Rowan-Rocketry/Control-Module/pcb/control-module.kicad_pcb

## KiCad design pcb/control-module.kicad_pcb (2025-05-28)

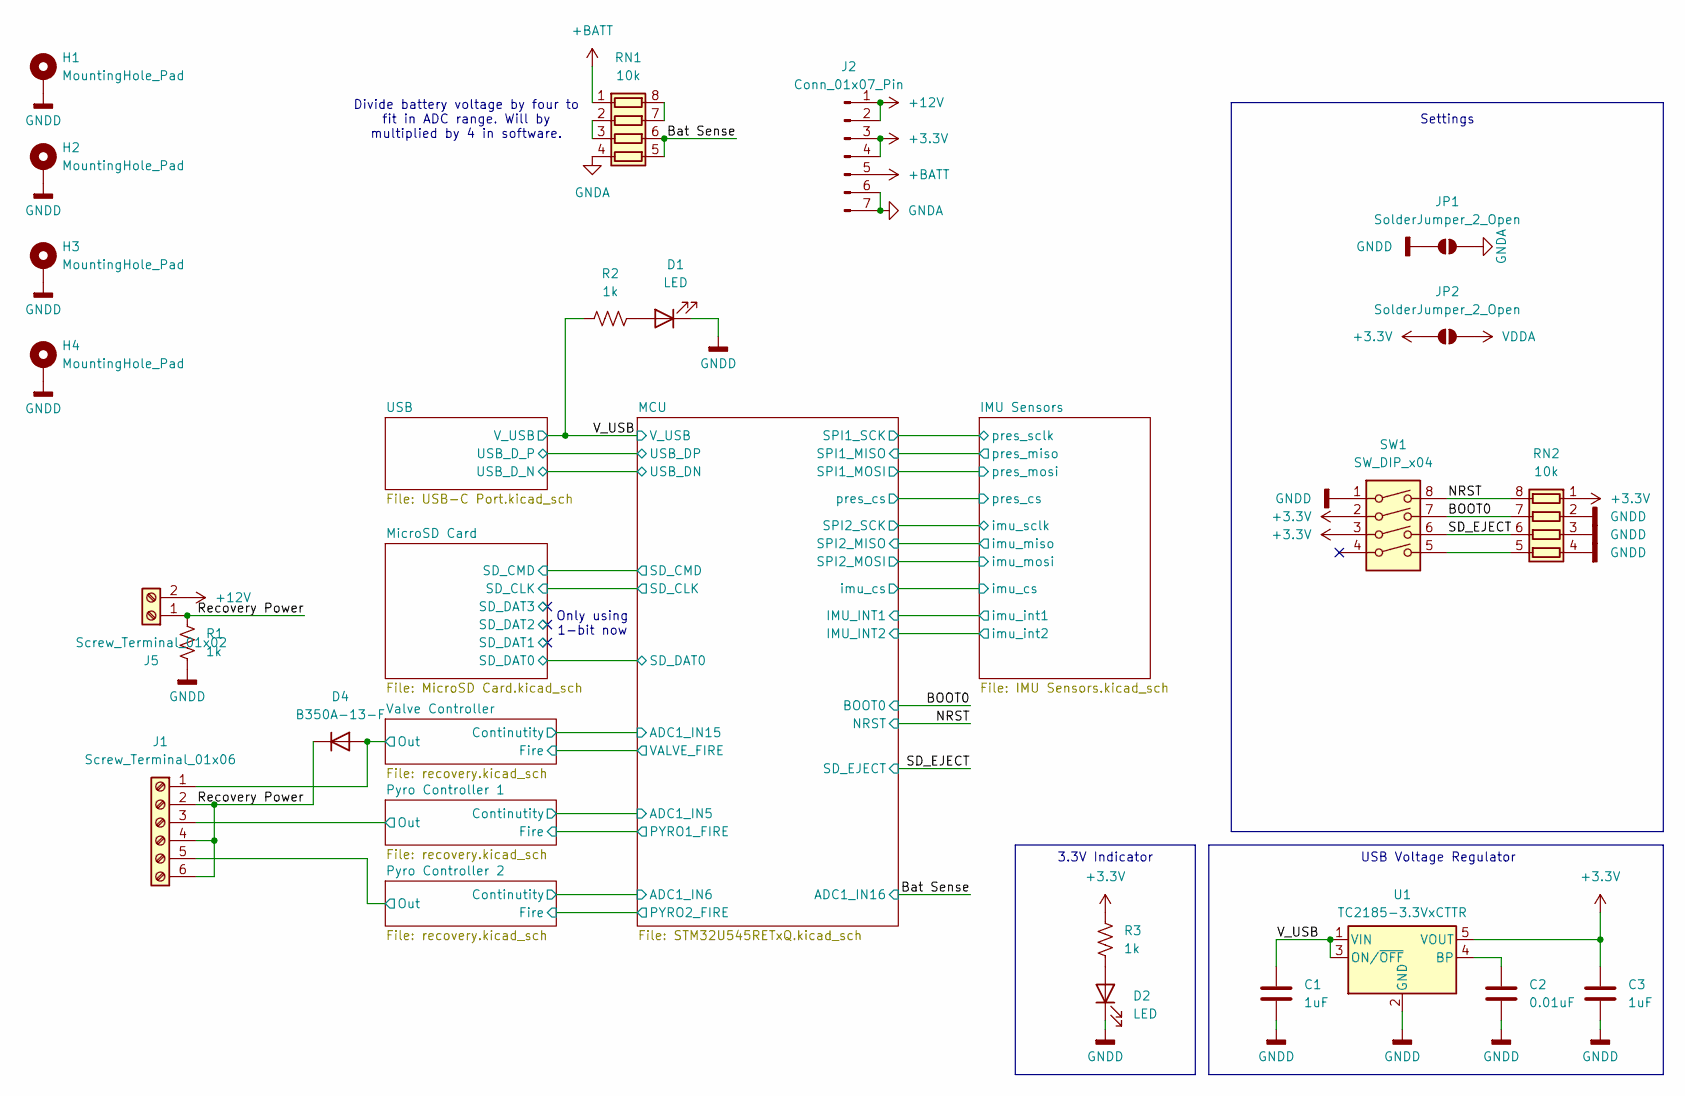
[picture p1: schematic control-module.kicad_sch, Control Module]

Parts:
C1, C3: 1uF; C_0603_1608Metric
C2: 0.01uF; C_0603_1608Metric
D1, D2: LED; LED_0603_1608Metric
D4: B350A-13-F; D_SOD-123F
H1, H2, H3, H4: MountingHole_Pad; MountingHole_3.2mm_M3_Pad_Via
J1: Screw_Terminal_01x06; TerminalBlock_Phoenix_MPT-0,5-6-2.54_1x06_P2.54mm_Horizontal
J2: Conn_01x07_Pin; PinHeader_1x07_P2.54mm_Vertical
J5: Screw_Terminal_01x02; TerminalBlock_Phoenix_MPT-0,5-2-2.54_1x02_P2.54mm_Horizontal
JP1, JP2: SolderJumper_2_Open; SolderJumper-2_P1.3mm_Open_RoundedPad1.0x1.5mm
R1, R2, R3: 1k; R_0603_1608Metric
RN1, RN2: 10k; R_Array_Convex_4x0612
SW1: SW_DIP_x04; SW_DIP_SPSTx04_Slide_Copal_CHS-04A_W5.08mm_P1.27mm_JPin
U1: TC2185-3.3VxCTTR; SOT-23-5

Connections:
+3.3V: C3.1, J2.3, J2.4, JP2.1 (A), R3.1, RN2.1 (R1.1), SW1.2, SW1.3, U1.5 (VOUT); also elsewhere on the board
+12V: J2.1, J2.2, J5.2
+BATT: J2.5, RN1.1 (R1.1)
/BOOT0: RN2.7 (R2.2), SW1.7; also elsewhere on the board
/Bat Sense: RN1.5 (R4.2), RN1.6 (R3.2); also elsewhere on the board
/NRST: RN2.8 (R1.2), SW1.8; also elsewhere on the board
/Pyro Controller 1/Out: J1.3; also elsewhere on the board
/Pyro Controller 2/Out: J1.5; also elsewhere on the board
/Recovery Power: D4.1 (K), J1.2, J1.4, J1.6, J5.1, R1.2
/SD_EJECT: RN2.6 (R3.2), SW1.6; also elsewhere on the board
/V_USB: C1.1, R2.1, U1.1 (VIN), U1.3 (ON/~OFF); also elsewhere on the board
/Valve Controller/Out: D4.2 (A), J1.1; also elsewhere on the board
GNDA: J2.6, J2.7, JP1.2 (B), RN1.4 (R4.1); also elsewhere on the board
GNDD: C1.2, C2.2, C3.2, D1.1 (K), D2.1 (K), H1.1, H2.1, H3.1, H4.1, JP1.1 (A), R1.1, RN2.2 (R2.1), RN2.3 (R3.1), RN2.4 (R4.1), SW1.1, U1.2 (GND); also elsewhere on the board
unnamed: D1.2 (A), R2.2
unnamed: D2.2 (A), R3.2
unnamed: RN1.7 (R2.2), RN1.8 (R1.2)
unnamed: RN1.2 (R2.1), RN1.3 (R3.1)
unnamed: RN2.5 (R4.2), SW1.5
unnamed: C2.1, U1.4 (BP)
VDDA: JP2.2 (B); also elsewhere on the board

Notes on the sheet:
Settings
Divide battery voltage by four to fit in ADC range. Will by multiplied by 4 in software.
3.3V Indicator
Only using 1-bit now
USB Voltage Regulator

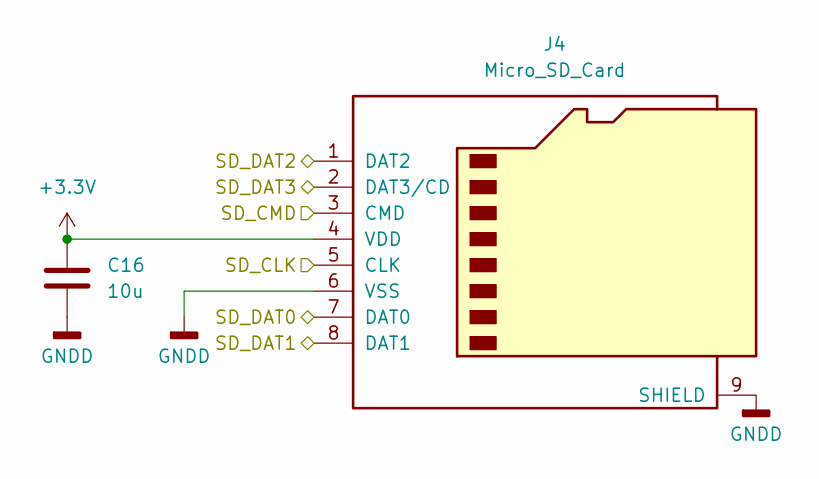
[picture p2: schematic MicroSD Card.kicad_sch, Ride-Along Module]

Parts:
C16: 10u; C_0603_1608Metric_Pad1.08x0.95mm_HandSolder
J4: Micro_SD_Card; microSD_HC_Molex_47219-2001

Connections:
+3.3V: C16.1, J4.4 (VDD); also elsewhere on the board
/MCU/SD_CLK: J4.5 (CLK); also elsewhere on the board
/MCU/SD_CMD: J4.3 (CMD); also elsewhere on the board
/MCU/SD_DAT0: J4.7 (DAT0); also elsewhere on the board
/MicroSD Card/SD_DAT1: J4.8 (DAT1)
/MicroSD Card/SD_DAT2: J4.1 (DAT2)
/MicroSD Card/SD_DAT3: J4.2 (DAT3/CD)
GNDD: C16.2, J4.6 (VSS), J4.9 (SHIELD); also elsewhere on the board

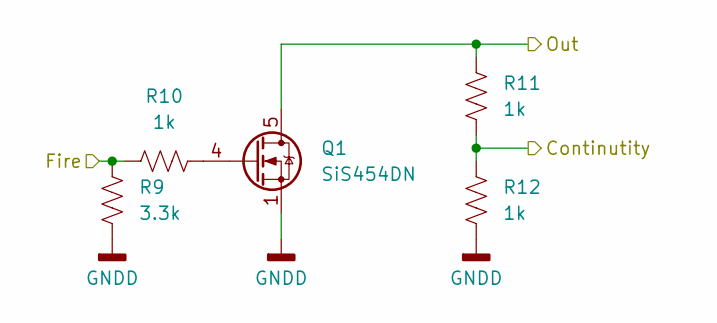
[picture p3: schematic recovery.kicad_sch]

Parts:
Q1: SiS454DN; Vishay_PowerPAK_1212-8_Single
R9: 3.3k; R_0603_1608Metric_Pad0.98x0.95mm_HandSolder
R10, R11, R12: 1k; R_0603_1608Metric_Pad0.98x0.95mm_HandSolder

Connections:
/MCU/ADC1_IN6: R11.1, R12.2; also elsewhere on the board
/MCU/PYRO2_FIRE: R9.2, R10.1; also elsewhere on the board
/Pyro Controller 2/Out: Q1.5 (D), R11.2; also elsewhere on the board
GNDD: Q1.1 (S), Q1.2 (S), Q1.3 (S), R9.1, R12.1; also elsewhere on the board
unnamed: Q1.4 (G), R10.2

Parts of its further copies:
Q2, Q3: SiS454DN; Vishay_PowerPAK_1212-8_Single
R13, R17: 3.3k; R_0603_1608Metric_Pad0.98x0.95mm_HandSolder
R14, R15, R16, R18, R19, R20: 1k; R_0603_1608Metric_Pad0.98x0.95mm_HandSolder

Connections of its further copies:
/MCU/ADC1_IN5: R19.1, R20.2; also elsewhere on the board
/MCU/ADC1_IN15: R15.1, R16.2; also elsewhere on the board
/MCU/PYRO1_FIRE: R17.2, R18.1; also elsewhere on the board
/MCU/VALVE_FIRE: R13.2, R14.1; also elsewhere on the board
/Pyro Controller 1/Out: Q3.5 (D), R19.2; also elsewhere on the board
/Valve Controller/Out: Q2.5 (D), R15.2; also elsewhere on the board
GNDD: Q2.1 (S), Q2.2 (S), Q2.3 (S), Q3.1 (S), Q3.2 (S), Q3.3 (S), R13.1, R16.1, R17.1, R20.1; also elsewhere on the board
unnamed: Q2.4 (G), R14.2
unnamed: Q3.4 (G), R18.2

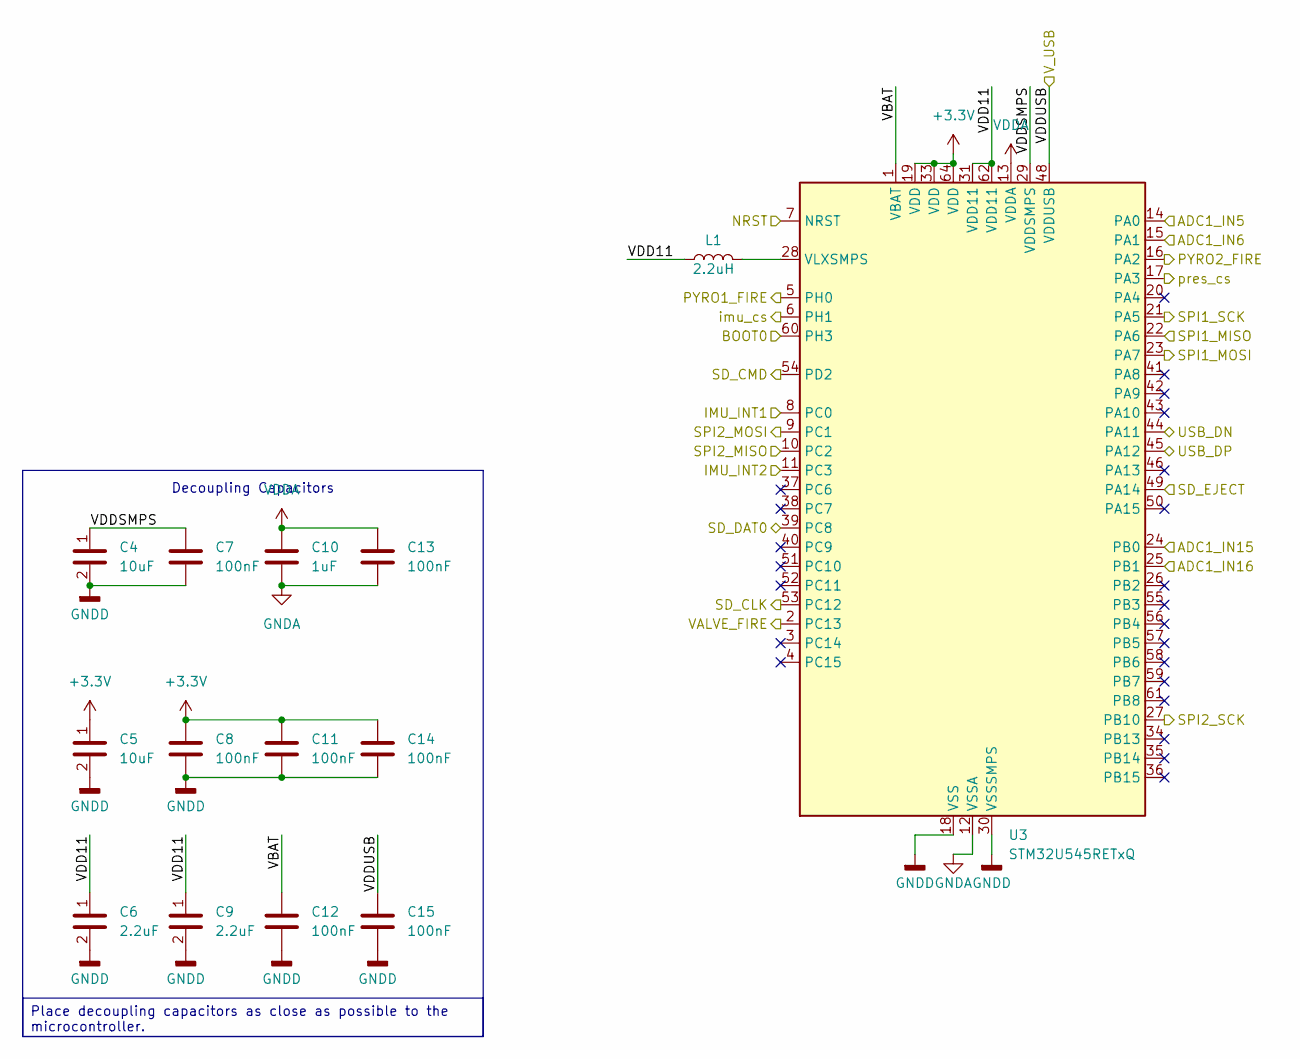
[picture p4: schematic STM32U545RETxQ.kicad_sch, Ride-Along Module]

Parts:
C4, C5: 10uF; C_0603_1608Metric_Pad1.08x0.95mm_HandSolder
C6, C9: 2.2uF; C_0603_1608Metric_Pad1.08x0.95mm_HandSolder
C7, C8, C11, C12, C13, C14, C15: 100nF; C_0603_1608Metric_Pad1.08x0.95mm_HandSolder
C10: 1uF; C_0603_1608Metric_Pad1.08x0.95mm_HandSolder
L1: 2.2uH; L_0603_1608Metric_Pad1.05x0.95mm_HandSolder
U3: STM32U545RETxQ; LQFP-64_10x10mm_P0.5mm

Connections:
+3.3V: C5.1, C8.1, C11.1, C14.1, U3.19 (VDD), U3.33 (VDD), U3.64 (VDD); also elsewhere on the board
/BOOT0: U3.60 (PH3); also elsewhere on the board
/Bat Sense: U3.25 (PB1); also elsewhere on the board
/IMU Sensors/imu_cs: U3.6 (PH1); also elsewhere on the board
/IMU Sensors/imu_int1: U3.8 (PC0); also elsewhere on the board
/IMU Sensors/imu_int2: U3.11 (PC3); also elsewhere on the board
/IMU Sensors/imu_miso: U3.10 (PC2); also elsewhere on the board
/IMU Sensors/imu_mosi: U3.9 (PC1); also elsewhere on the board
/IMU Sensors/imu_sclk: U3.27 (PB10); also elsewhere on the board
/IMU Sensors/pres_cs: U3.17 (PA3); also elsewhere on the board
/IMU Sensors/pres_miso: U3.22 (PA6); also elsewhere on the board
/IMU Sensors/pres_mosi: U3.23 (PA7); also elsewhere on the board
/IMU Sensors/pres_sclk: U3.21 (PA5); also elsewhere on the board
/MCU/ADC1_IN5: U3.14 (PA0); also elsewhere on the board
/MCU/ADC1_IN6: U3.15 (PA1); also elsewhere on the board
/MCU/ADC1_IN15: U3.24 (PB0); also elsewhere on the board
/MCU/PYRO1_FIRE: U3.5 (PH0); also elsewhere on the board
/MCU/PYRO2_FIRE: U3.16 (PA2); also elsewhere on the board
/MCU/SD_CLK: U3.53 (PC12); also elsewhere on the board
/MCU/SD_CMD: U3.54 (PD2); also elsewhere on the board
/MCU/SD_DAT0: U3.39 (PC8); also elsewhere on the board
/MCU/USB_DN: U3.44 (PA11); also elsewhere on the board
/MCU/USB_DP: U3.45 (PA12); also elsewhere on the board
/MCU/VALVE_FIRE: U3.2 (PC13); also elsewhere on the board
/MCU/VBAT: C12.1, U3.1 (VBAT)
/MCU/VDD11: C6.1, C9.1, L1.1, U3.31 (VDD11), U3.62 (VDD11)
/MCU/VDDSMPS: C4.1, C7.1, U3.29 (VDDSMPS)
/NRST: U3.7 (NRST); also elsewhere on the board
/SD_EJECT: U3.49 (PA14); also elsewhere on the board
/V_USB: C15.1, U3.48 (VDDUSB); also elsewhere on the board
GNDA: C10.2, C13.2, U3.12 (VSSA); also elsewhere on the board
GNDD: C4.2, C5.2, C6.2, C7.2, C8.2, C9.2, C11.2, C12.2, C14.2, C15.2, U3.18 (VSS), U3.30 (VSSSMPS), U3.32 (VSS), U3.47 (VSS), U3.63 (VSS); also elsewhere on the board
unnamed: L1.2, U3.28 (VLXSMPS)
VDDA: C10.1, C13.1, U3.13 (VDDA); also elsewhere on the board

Notes on the sheet:
Decoupling Capacitors
Place decoupling capacitors as close as possible to the microcontroller.

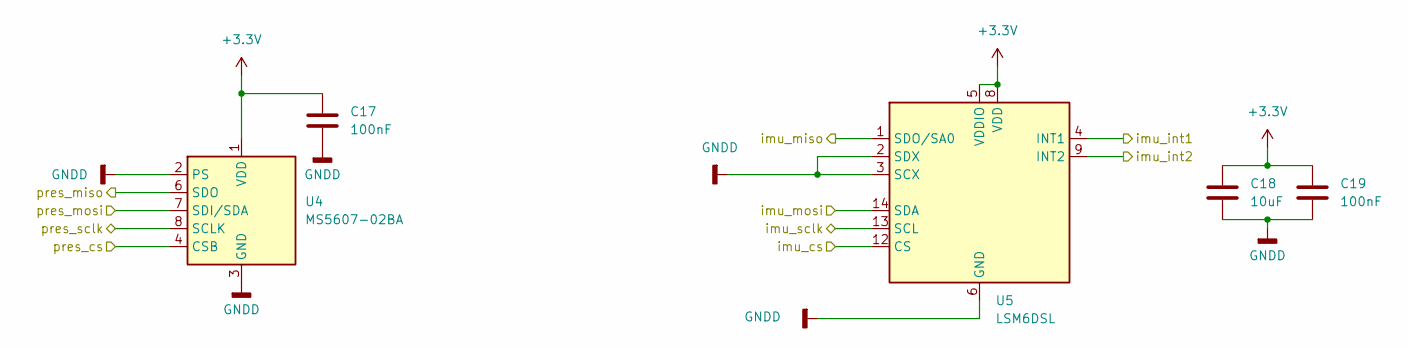
[picture p5: schematic IMU Sensors.kicad_sch, Ride-Along Module]

Parts:
C17, C19: 100nF; C_0603_1608Metric_Pad1.08x0.95mm_HandSolder
C18: 10uF; C_0603_1608Metric_Pad1.08x0.95mm_HandSolder
U4: MS5607-02BA; LGA-8_3x5mm_P1.25mm
U5: LSM6DSL; LGA-14_3x2.5mm_P0.5mm_LayoutBorder3x4y

Connections:
+3.3V: C17.1, C18.1, C19.1, U4.1 (VDD), U5.5 (VDDIO), U5.8 (VDD); also elsewhere on the board
/IMU Sensors/imu_cs: U5.12 (CS); also elsewhere on the board
/IMU Sensors/imu_int1: U5.4 (INT1); also elsewhere on the board
/IMU Sensors/imu_int2: U5.9 (INT2); also elsewhere on the board
/IMU Sensors/imu_miso: U5.1 (SDO/SA0); also elsewhere on the board
/IMU Sensors/imu_mosi: U5.14 (SDA); also elsewhere on the board
/IMU Sensors/imu_sclk: U5.13 (SCL); also elsewhere on the board
/IMU Sensors/pres_cs: U4.4 (CSB), U4.5 (CSB); also elsewhere on the board
/IMU Sensors/pres_miso: U4.6 (SDO); also elsewhere on the board
/IMU Sensors/pres_mosi: U4.7 (SDI/SDA); also elsewhere on the board
/IMU Sensors/pres_sclk: U4.8 (SCLK); also elsewhere on the board
GNDD: C17.2, C18.2, C19.2, U4.2 (PS), U4.3 (GND), U5.2 (SDX), U5.3 (SCX), U5.6 (GND), U5.7 (GND); also elsewhere on the board

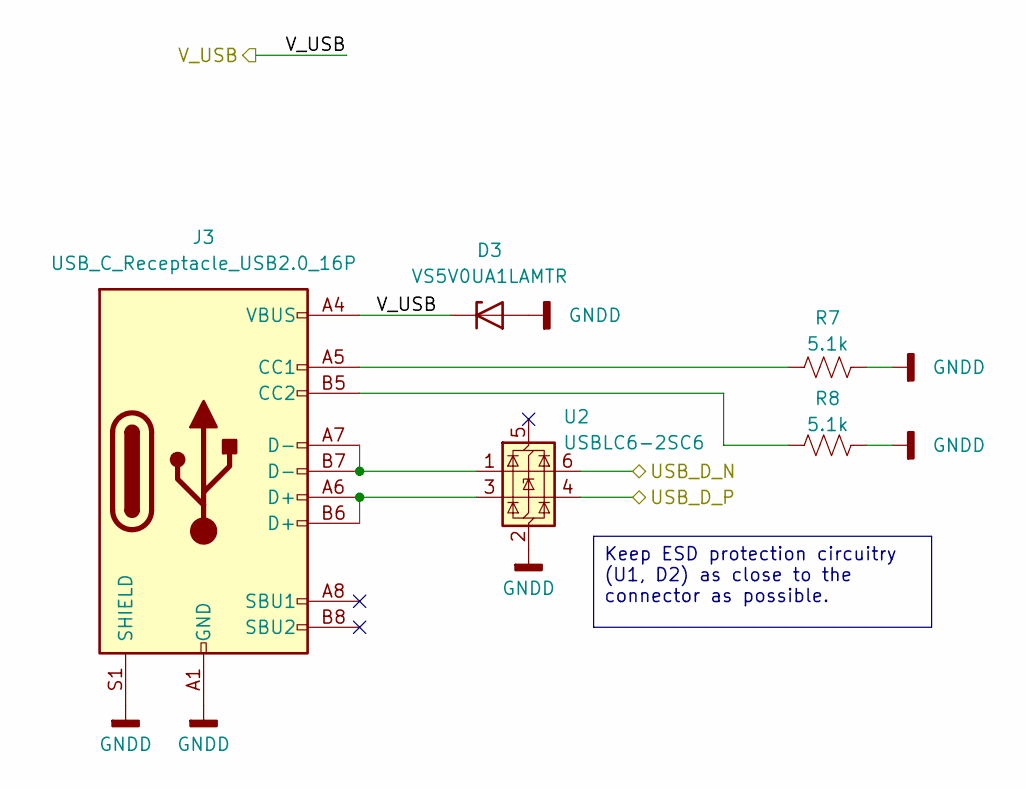
[picture p6: schematic USB-C Port.kicad_sch, Ride-Along Module]

Parts:
D3: VS5V0UA1LAMTR; D_SOD-128
J3: USB_C_Receptacle_USB2.0_16P; USB_C_Receptacle_GCT_USB4105-xx-A_16P_TopMnt_Horizontal
R7, R8: 5.1k; R_0603_1608Metric
U2: USBLC6-2SC6; SOT-23-6

Connections:
/MCU/USB_DN: U2.6 (I/O1); also elsewhere on the board
/MCU/USB_DP: U2.4 (I/O2); also elsewhere on the board
/V_USB: D3.1 (K), J3.A4 (VBUS), J3.A9 (VBUS), J3.B4 (VBUS), J3.B9 (VBUS); also elsewhere on the board
GNDD: D3.2 (A), J3.A1 (GND), J3.A12 (GND), J3.B1 (GND), J3.B12 (GND), J3.S1 (SHIELD), R7.2, R8.2, U2.2 (GND); also elsewhere on the board
unnamed: J3.A5 (CC1), R7.1
unnamed: J3.B5 (CC2), R8.1
unnamed: J3.A6 (D+), J3.B6 (D+), U2.3 (I/O2)
unnamed: J3.A7 (D-), J3.B7 (D-), U2.1 (I/O1)

Notes on the sheet:
Keep ESD protection circuitry (U1, D2) as close to the connector as possible.

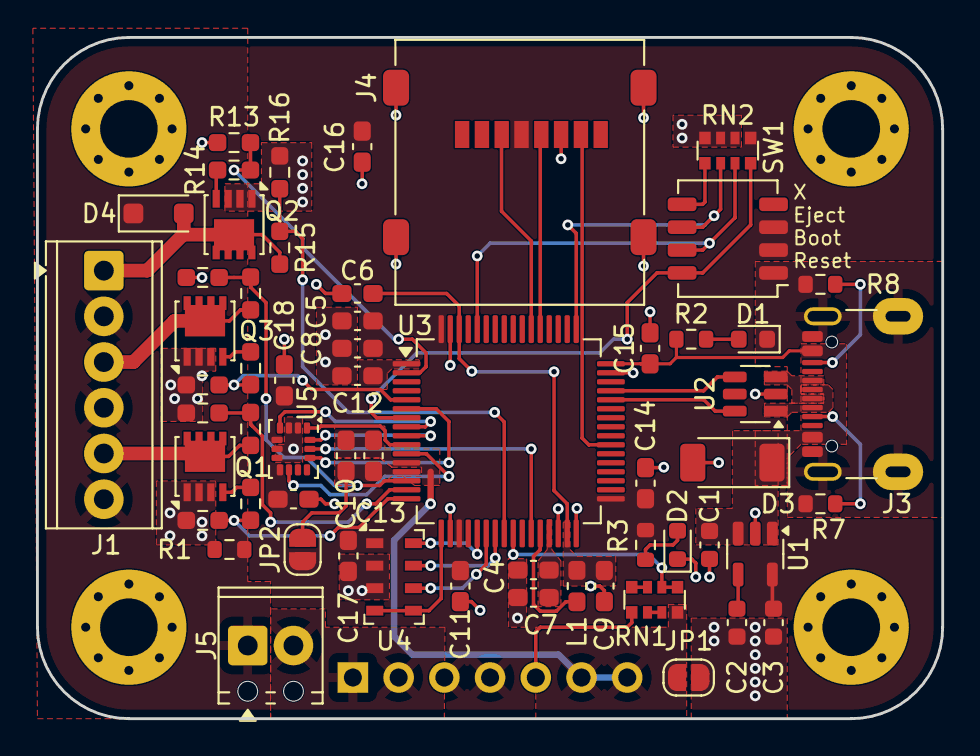
[picture p7: board control-module.kicad_pcb from above]

Board: 2 copper layers, 50.3 x 37.8 mm, 63 parts (1 on the bottom side), 53 nets.
