Rowan-Rocketry/Control-Module/ride-pcb/ride-along-module.kicad_pcb

## KiCad design ride-pcb/ride-along-module.kicad_pcb (2025-05-20)

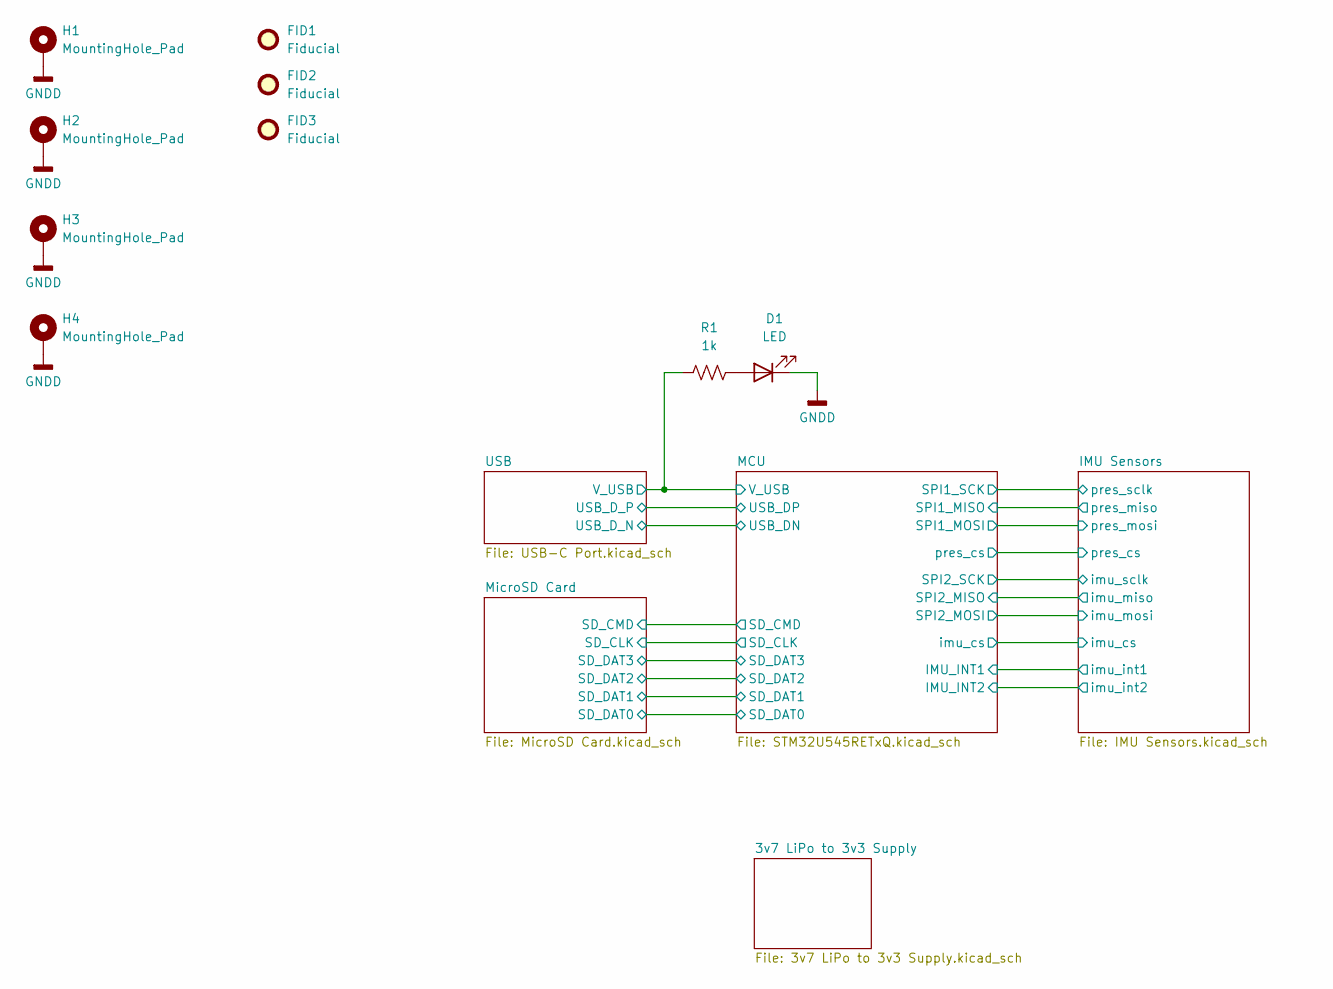
[picture p8: schematic ride-along-module.kicad_sch, Ride-Along Module]

Parts:
D1: LED; LED_0603_1608Metric
FID1, FID2, FID3: Fiducial; Fiducial_1mm_Mask3mm
H1, H2, H3, H4: MountingHole_Pad; MountingHole_3.2mm_M3_Pad_Via
R1: 1k; R_0603_1608Metric

Connections:
/MCU/VDDUSB: R1.1; also elsewhere on the board
GNDD: D1.1 (K), H1.1, H2.1, H3.1, H4.1; also elsewhere on the board
unnamed: D1.2 (A), R1.2

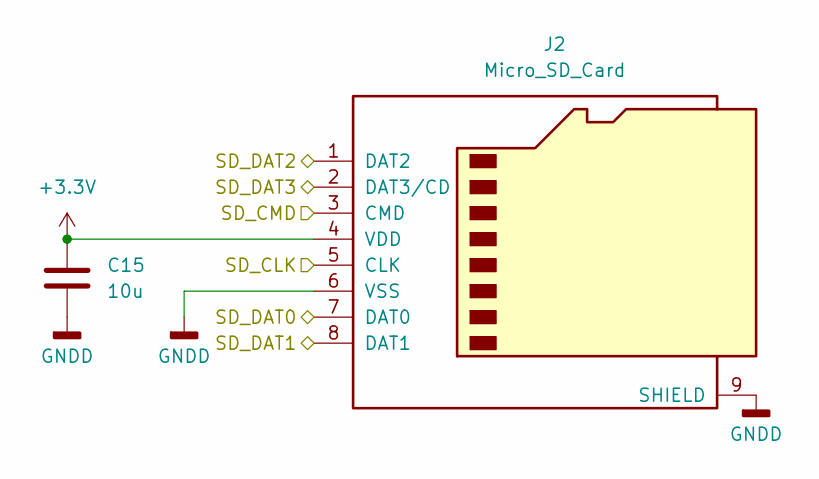
[picture p9: schematic MicroSD Card.kicad_sch, Ride-Along Module]

Parts:
C15: 10u; C_0603_1608Metric
J2: Micro_SD_Card; microSD_HC_Molex_47219-2001

Connections:
+3.3V: C15.1, J2.4 (VDD); also elsewhere on the board
/MCU/SD_CLK: J2.5 (CLK); also elsewhere on the board
/MCU/SD_CMD: J2.3 (CMD); also elsewhere on the board
/MCU/SD_DAT0: J2.7 (DAT0); also elsewhere on the board
/MCU/SD_DAT1: J2.8 (DAT1); also elsewhere on the board
/MCU/SD_DAT2: J2.1 (DAT2); also elsewhere on the board
/MCU/SD_DAT3: J2.2 (DAT3/CD); also elsewhere on the board
GNDD: C15.2, J2.6 (VSS), J2.9 (SHIELD); also elsewhere on the board

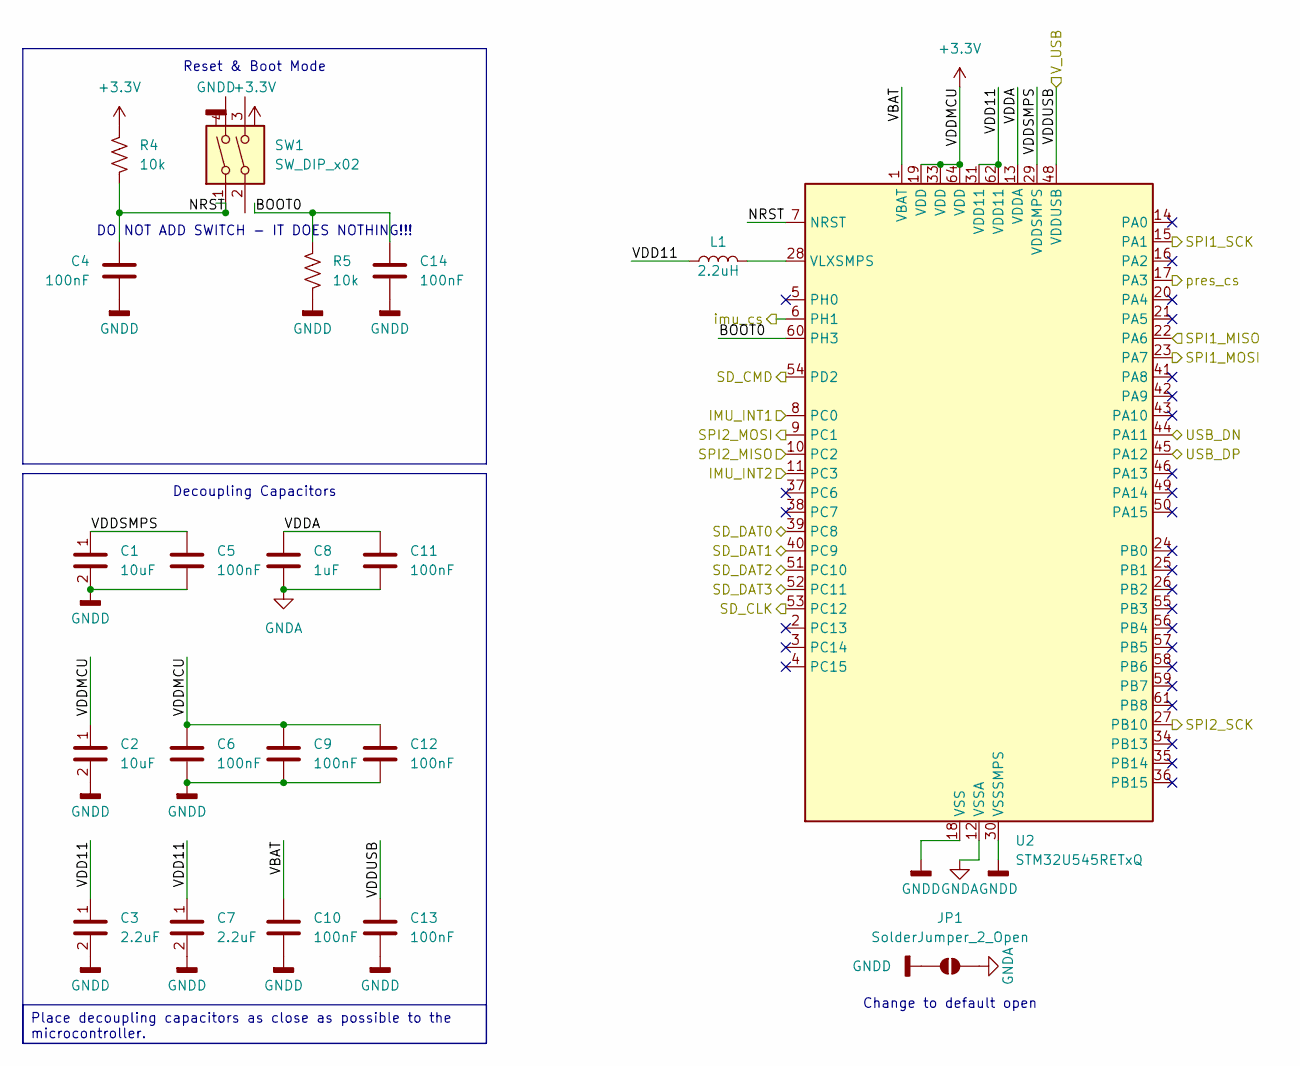
[picture p10: schematic STM32U545RETxQ.kicad_sch, Ride-Along Module]

Parts:
C1, C2: 10uF; C_0402_1005Metric
C3, C7: 2.2uF; C_0402_1005Metric
C4, C14: 100nF; C_0603_1608Metric
C5, C6, C9, C10, C11, C12, C13: 100nF; C_0402_1005Metric
C8: 1uF; C_0402_1005Metric
JP1: SolderJumper_2_Open; SolderJumper-2_P1.3mm_Open_RoundedPad1.0x1.5mm
L1: 2.2uH; L_0402_1005Metric
R4, R5: 10k; R_0603_1608Metric
SW1: SW_DIP_x02
U2: STM32U545RETxQ; LQFP-64_10x10mm_P0.5mm

Connections:
+3.3V: C2.1, C6.1, C9.1, C12.1, R4.1, SW1.4, U2.19 (VDD), U2.33 (VDD), U2.64 (VDD); also elsewhere on the board
/IMU Sensors/imu_cs: U2.6 (PH1); also elsewhere on the board
/IMU Sensors/imu_int1: U2.8 (PC0); also elsewhere on the board
/IMU Sensors/imu_int2: U2.11 (PC3); also elsewhere on the board
/IMU Sensors/imu_miso: U2.10 (PC2); also elsewhere on the board
/IMU Sensors/imu_mosi: U2.9 (PC1); also elsewhere on the board
/IMU Sensors/imu_sclk: U2.27 (PB10); also elsewhere on the board
/IMU Sensors/pres_cs: U2.17 (PA3); also elsewhere on the board
/IMU Sensors/pres_miso: U2.22 (PA6); also elsewhere on the board
/IMU Sensors/pres_mosi: U2.23 (PA7); also elsewhere on the board
/IMU Sensors/pres_sclk: U2.15 (PA1); also elsewhere on the board
/MCU/BOOT0: C14.2, R5.1, SW1.3, U2.60 (PH3)
/MCU/NRST: C4.2, R4.2, SW1.1, U2.7 (NRST)
/MCU/SD_CLK: U2.53 (PC12); also elsewhere on the board
/MCU/SD_CMD: U2.54 (PD2); also elsewhere on the board
/MCU/SD_DAT0: U2.39 (PC8); also elsewhere on the board
/MCU/SD_DAT1: U2.40 (PC9); also elsewhere on the board
/MCU/SD_DAT2: U2.51 (PC10); also elsewhere on the board
/MCU/SD_DAT3: U2.52 (PC11); also elsewhere on the board
/MCU/USB_DN: U2.44 (PA11); also elsewhere on the board
/MCU/USB_DP: U2.45 (PA12); also elsewhere on the board
/MCU/VBAT: C10.1, U2.1 (VBAT)
/MCU/VDD11: C3.1, C7.1, L1.1, U2.31 (VDD11), U2.62 (VDD11)
/MCU/VDDA: C8.1, C11.1, U2.13 (VDDA)
/MCU/VDDSMPS: C1.1, C5.1, U2.29 (VDDSMPS)
/MCU/VDDUSB: C13.1, U2.48 (VDDUSB); also elsewhere on the board
GNDA: C8.2, C11.2, JP1.2 (B), U2.12 (VSSA)
GNDD: C1.2, C2.2, C3.2, C4.1, C5.2, C6.2, C7.2, C9.2, C10.2, C12.2, C13.2, C14.1, JP1.1 (A), R5.2, SW1.2, U2.18 (VSS), U2.30 (VSSSMPS), U2.32 (VSS), U2.47 (VSS), U2.63 (VSS); also elsewhere on the board
unnamed: L1.2, U2.28 (VLXSMPS)

Notes on the sheet:
Decoupling Capacitors
Reset & Boot Mode
Change to default open
DO NOT ADD SWITCH - IT DOES NOTHING!!!
Place decoupling capacitors as close as possible to the microcontroller.

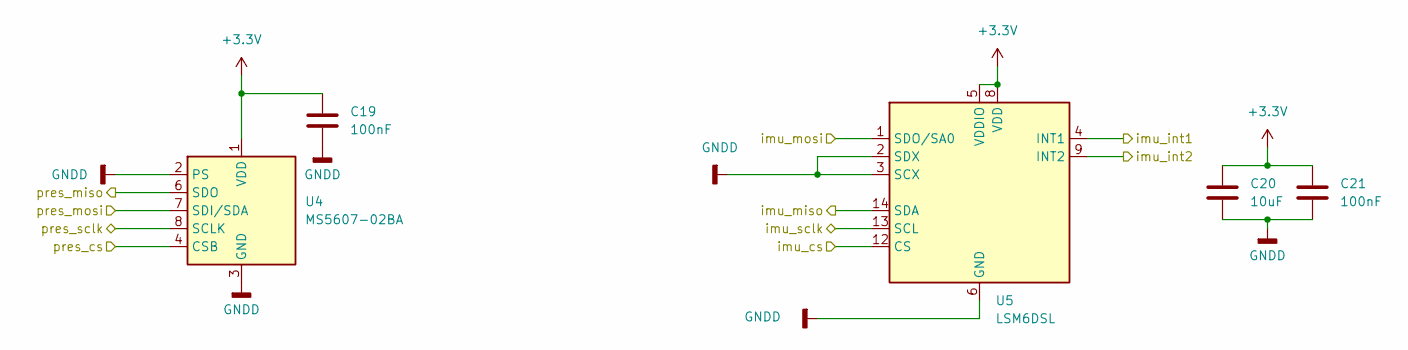
[picture p11: schematic IMU Sensors.kicad_sch, Ride-Along Module]

Parts:
C19, C21: 100nF; C_0603_1608Metric
C20: 10uF; CP_EIA-3216-18_Kemet-A
U4: MS5607-02BA; LGA-8_3x5mm_P1.25mm
U5: LSM6DSL; LGA-14_3x2.5mm_P0.5mm_LayoutBorder3x4y

Connections:
+3.3V: C19.1, C20.1, C21.1, U4.1 (VDD), U5.5 (VDDIO), U5.8 (VDD); also elsewhere on the board
/IMU Sensors/imu_cs: U5.12 (CS); also elsewhere on the board
/IMU Sensors/imu_int1: U5.4 (INT1); also elsewhere on the board
/IMU Sensors/imu_int2: U5.9 (INT2); also elsewhere on the board
/IMU Sensors/imu_miso: U5.14 (SDA); also elsewhere on the board
/IMU Sensors/imu_mosi: U5.1 (SDO/SA0); also elsewhere on the board
/IMU Sensors/imu_sclk: U5.13 (SCL); also elsewhere on the board
/IMU Sensors/pres_cs: U4.4 (CSB), U4.5 (CSB); also elsewhere on the board
/IMU Sensors/pres_miso: U4.6 (SDO); also elsewhere on the board
/IMU Sensors/pres_mosi: U4.7 (SDI/SDA); also elsewhere on the board
/IMU Sensors/pres_sclk: U4.8 (SCLK); also elsewhere on the board
GNDD: C19.2, C20.2, C21.2, U4.2 (PS), U4.3 (GND), U5.2 (SDX), U5.3 (SCX), U5.6 (GND), U5.7 (GND); also elsewhere on the board

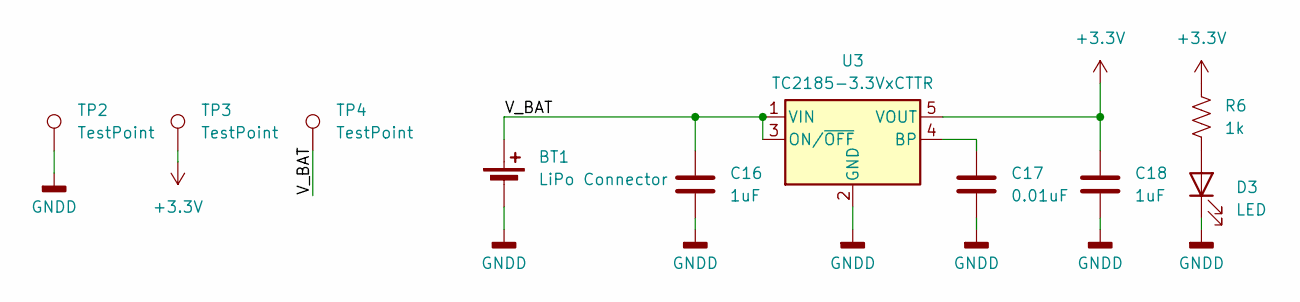
[picture p12: schematic 3v7 LiPo to 3v3 Supply.kicad_sch, Ride-Along Module]

Parts:
BT1: LiPo Connector; JST_PH_B2B-PH-K_1x02_P2.00mm_Vertical
C16, C18: 1uF; C_0603_1608Metric
C17: 0.01uF; C_0603_1608Metric
D3: LED; LED_0603_1608Metric
R6: 1k; R_0603_1608Metric
TP2, TP3, TP4: TestPoint; TestPoint_Loop_D2.60mm_Drill1.6mm_Beaded
U3: TC2185-3.3VxCTTR; SOT-23-5

Connections:
+3.3V: C18.1, R6.1, TP3.1, U3.5 (VOUT); also elsewhere on the board
/3v7 LiPo to 3v3 Supply/V_BAT: BT1.1 (+), C16.1, TP4.1, U3.1 (VIN), U3.3 (ON/~OFF)
GNDD: BT1.2 (-), C16.2, C17.2, C18.2, D3.1 (K), TP2.1, U3.2 (GND); also elsewhere on the board
unnamed: D3.2 (A), R6.2
unnamed: C17.1, U3.4 (BP)

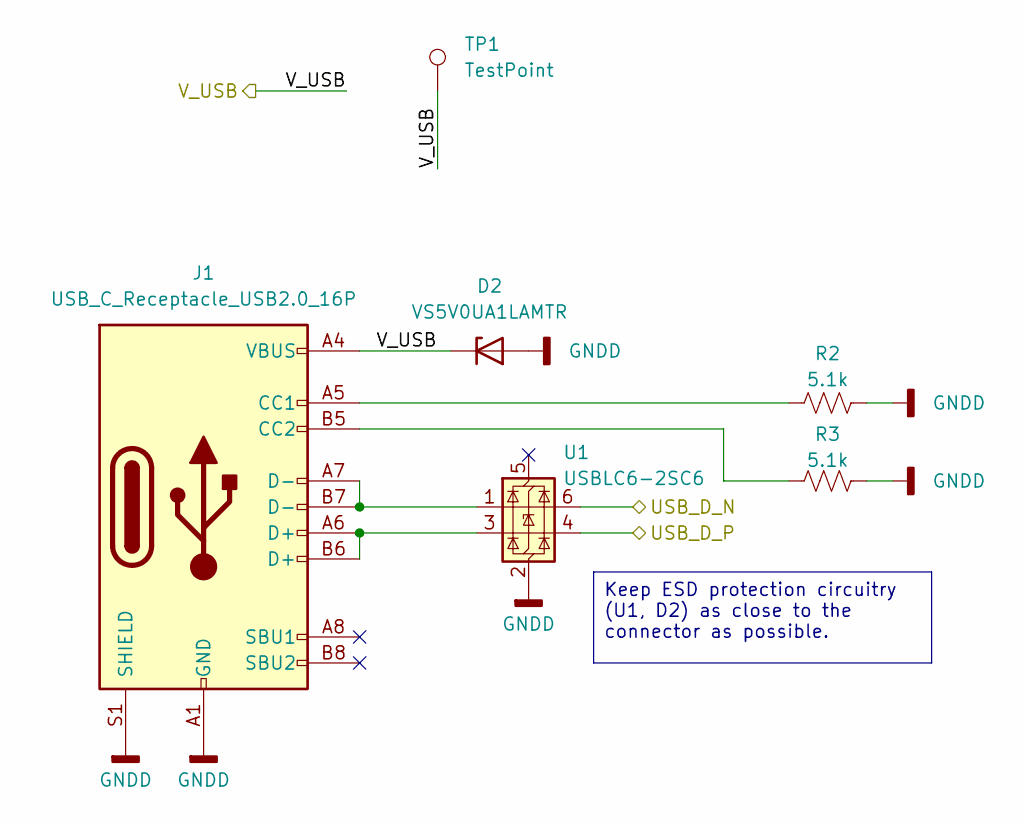
[picture p13: schematic USB-C Port.kicad_sch, Ride-Along Module]

Parts:
D2: VS5V0UA1LAMTR; D_SOD-128
J1: USB_C_Receptacle_USB2.0_16P; USB_C_Receptacle_GCT_USB4105-xx-A_16P_TopMnt_Horizontal
R2, R3: 5.1k; R_0603_1608Metric
TP1: TestPoint; TestPoint_Loop_D2.60mm_Drill1.6mm_Beaded
U1: USBLC6-2SC6; SOT-23-6

Connections:
/MCU/USB_DN: U1.6 (I/O1); also elsewhere on the board
/MCU/USB_DP: U1.4 (I/O2); also elsewhere on the board
/MCU/VDDUSB: D2.1 (K), J1.A4 (VBUS), J1.A9 (VBUS), J1.B4 (VBUS), J1.B9 (VBUS), TP1.1; also elsewhere on the board
GNDD: D2.2 (A), J1.A1 (GND), J1.A12 (GND), J1.B1 (GND), J1.B12 (GND), J1.S1 (SHIELD), R2.2, R3.2, U1.2 (GND); also elsewhere on the board
unnamed: J1.A5 (CC1), R2.1
unnamed: J1.B5 (CC2), R3.1
unnamed: J1.A6 (D+), J1.B6 (D+), U1.3 (I/O2)
unnamed: J1.A7 (D-), J1.B7 (D-), U1.1 (I/O1)

Notes on the sheet:
Keep ESD protection circuitry (U1, D2) as close to the connector as possible.

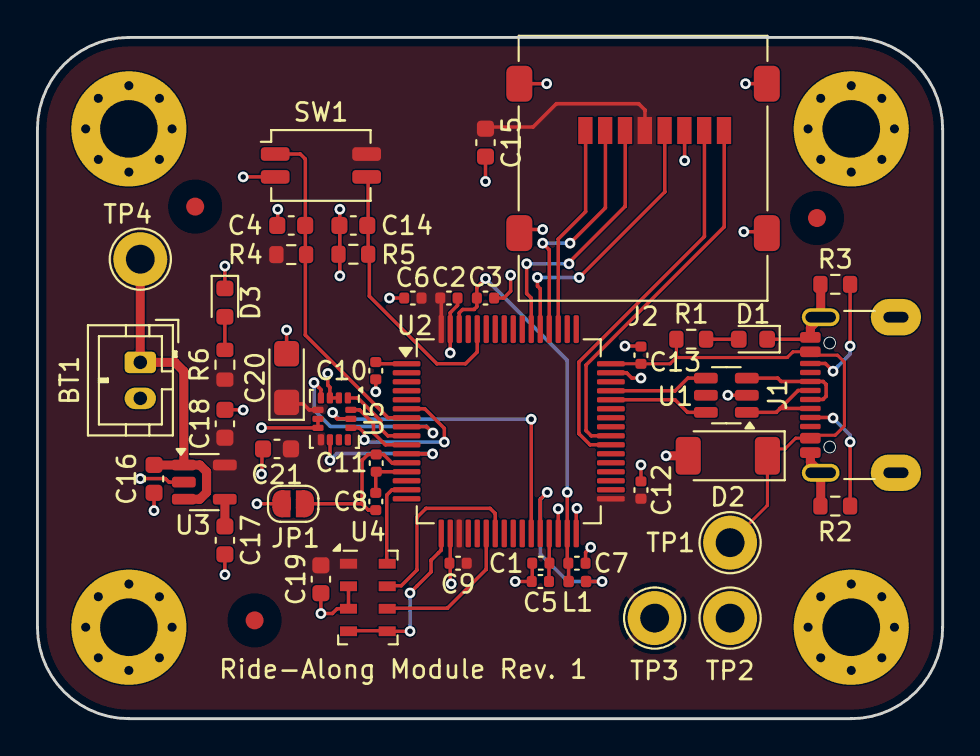
[picture p14: board ride-along-module.kicad_pcb from above]

Board: 2 copper layers, 50.3 x 37.8 mm, 52 parts (0 on the bottom side), 37 nets.
