Rowan-Rocketry/Control-Module/(commit log)

2025-05-20 Upgraded Ride-Along module for active flight
    [3v7 LiPo to 3v3 Supply.kicad_sch, IMU Sensors.kicad_sch, MicroSD Card.kicad_sch, STM32U545RETxQ.kicad_sch, Sensors.kicad_sch, USB-C Port.kicad_sch, USB-C-Interface.kicad_sch, control-module.csv]
2025-05-20 Changed pin order on recovery connections
    [control-module.kicad_pcb, control-module.kicad_sch]
2025-05-28 Revision 1
    [IMU Sensors.kicad_sch, MicroSD Card.kicad_sch, STM32U545RETxQ.kicad_sch, USB-C Port.kicad_sch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]
